cvra/kicad-lib/3Dmodels/Capacitors/CAP0402.step

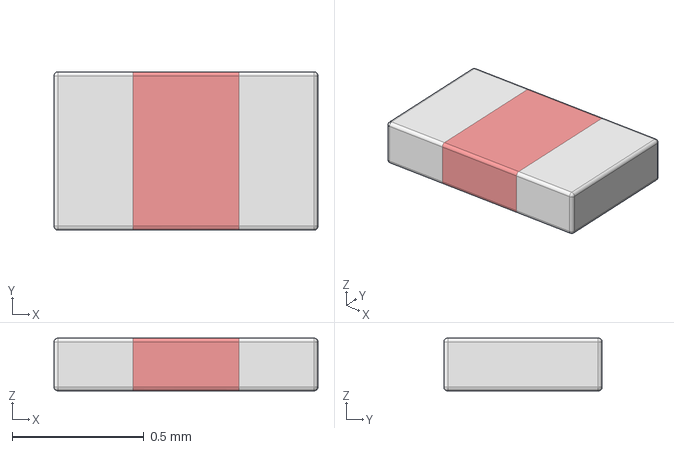
[picture p1: CAD file, 2016-01-29]
3Dmodels/Capacitors/CAP0402.step
1.00 x 0.6 x 0.2 mm
