cvra/kicad-lib/3Dmodels/Diverse/ESP-12.step

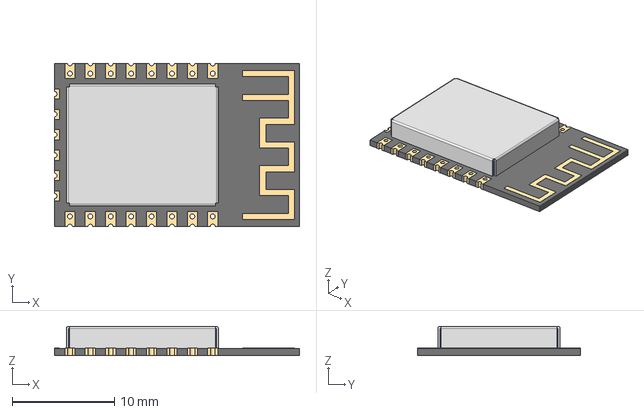
[picture p2: CAD file, 2016-06-26]
3Dmodels/Diverse/ESP-12.step
24.0 x 16.0 x 2.86 mm
