cvra/kicad-lib/3Dmodels/LEDs/0603_right_angle.stp

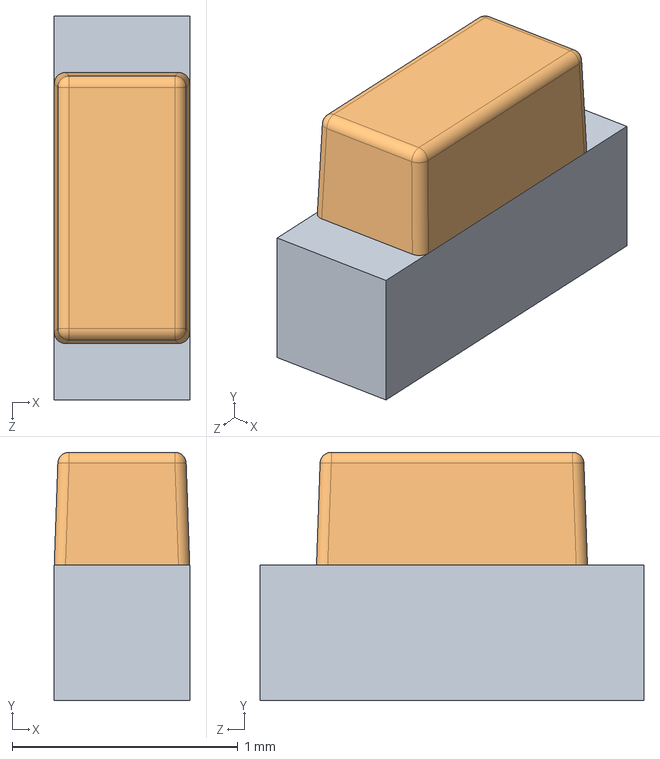
[picture p3: CAD file, 2020-04-17]
3Dmodels/LEDs/0603_right_angle.stp
0.6 x 1.10 x 1.70 mm
