cvra/kicad-lib/3Dmodels/MolexPicoblade/molexpicoblade-horizontal-th-4.step

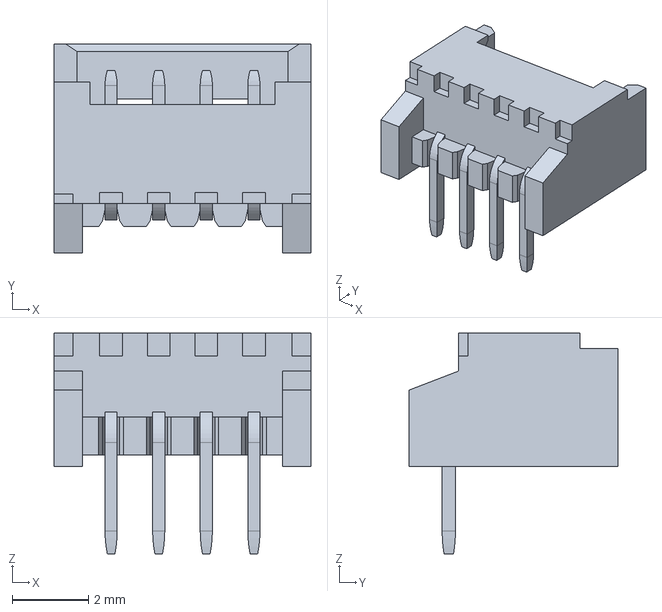
[picture p4: CAD file, 2020-04-10]
3Dmodels/MolexPicoblade/molexpicoblade-horizontal-th-4.step
6.75 x 5.50 x 5.80 mm
