cvra/kicad-lib/3Dmodels/Resistors/RES0603.stp

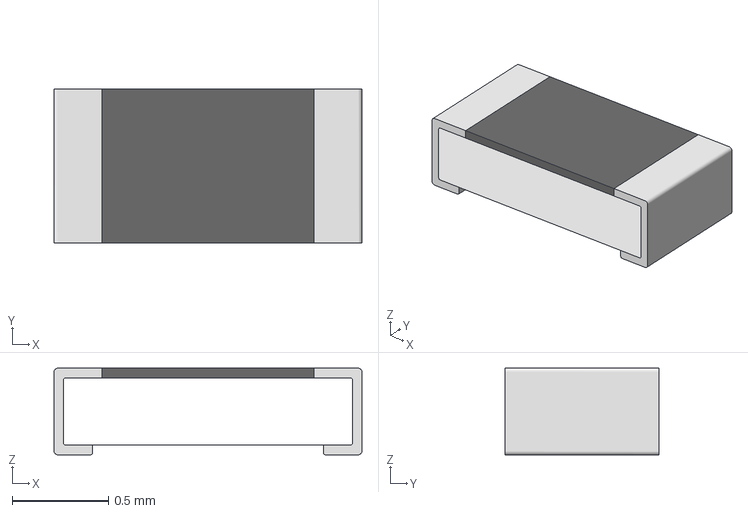
[picture p5: CAD file, 2016-02-28]
3Dmodels/Resistors/RES0603.stp
1.60 x 0.8 x 0.45 mm
