cvra/kicad-lib/3Dmodels/Sensors/MS5611.step

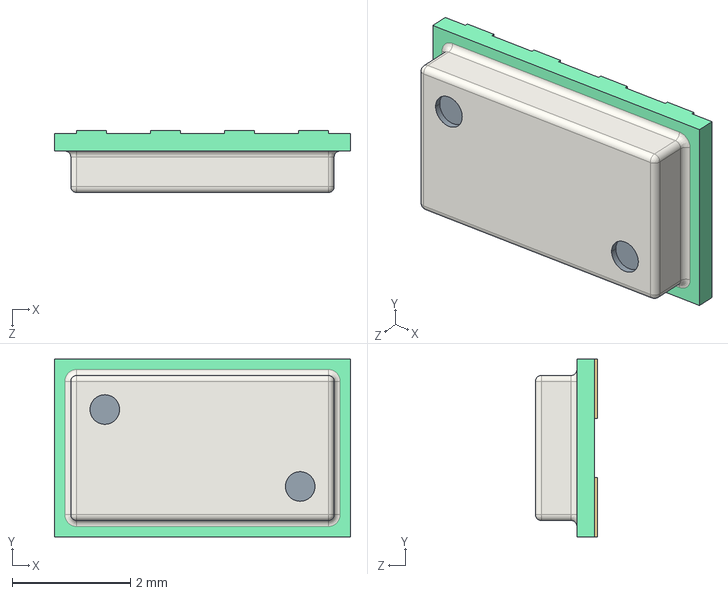
[picture p6: CAD file, 2016-02-28]
3Dmodels/Sensors/MS5611.step
5.00 x 3.00 x 1.05 mm
