cvra/kicad-lib/3Dmodels/SMD/sot363.stp

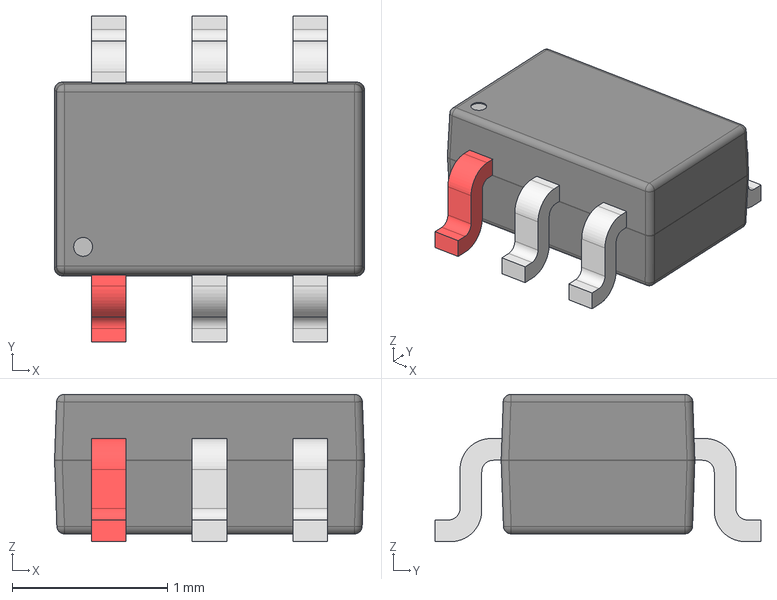
[picture p7: CAD file, 2016-06-04]
3Dmodels/SMD/sot363.stp
2.00 x 2.10 x 0.95 mm
