cvra/kicad-lib/3Dmodels/Switches/CFPA-1FB4-A2T.stp

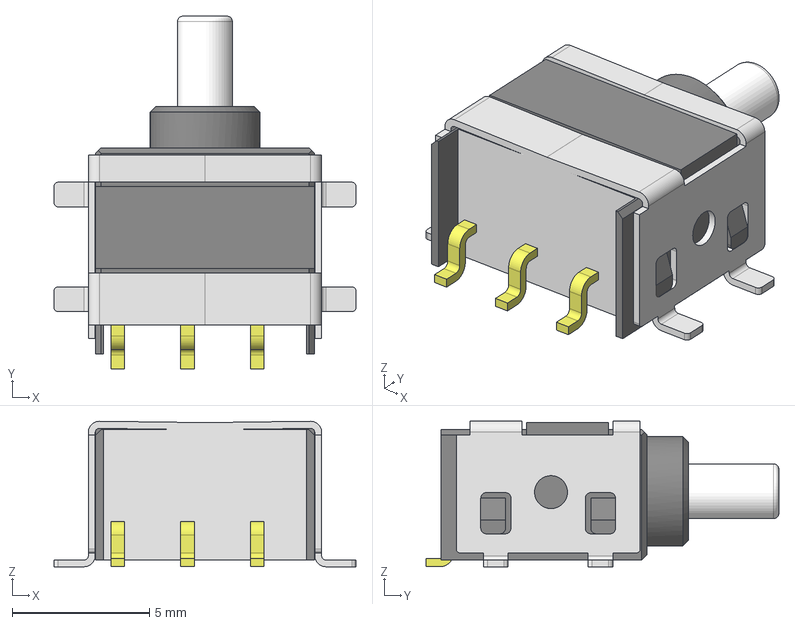
[picture p8: CAD file, 2020-04-10]
3Dmodels/Switches/CFPA-1FB4-A2T.stp
11.0 x 12.9 x 5.30 mm
_CFPA body
_CFPA button
