cvra/kicad-lib/3Dmodels/TSSOP/tssop28.step

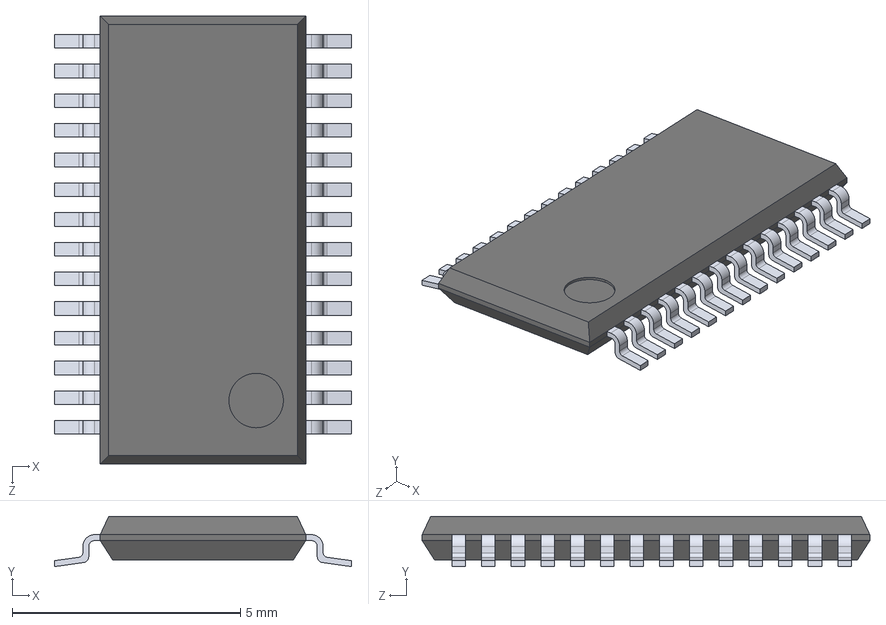
[picture p9: CAD file, 2016-06-04]
3Dmodels/TSSOP/tssop28.step
6.50 x 1.10 x 9.80 mm
