cvra/kicad-lib/3Dmodels/Diverse/Crystal_SMD_ABS07.step

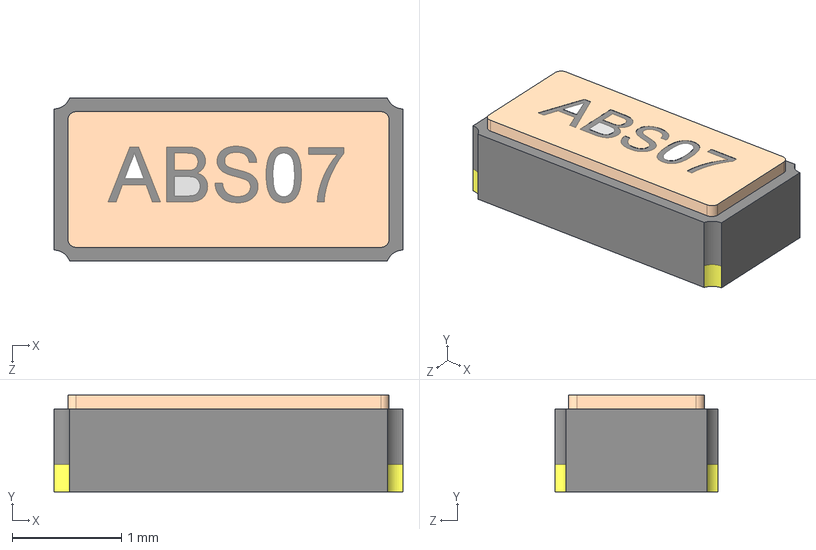
[picture p10: CAD file, 2016-06-04]
3Dmodels/Diverse/Crystal_SMD_ABS07.step
3.20 x 0.889 x 1.50 mm
