cvra/kicad-lib/3Dmodels/LEDs/CRGB1318FSE_rgb_led.stp

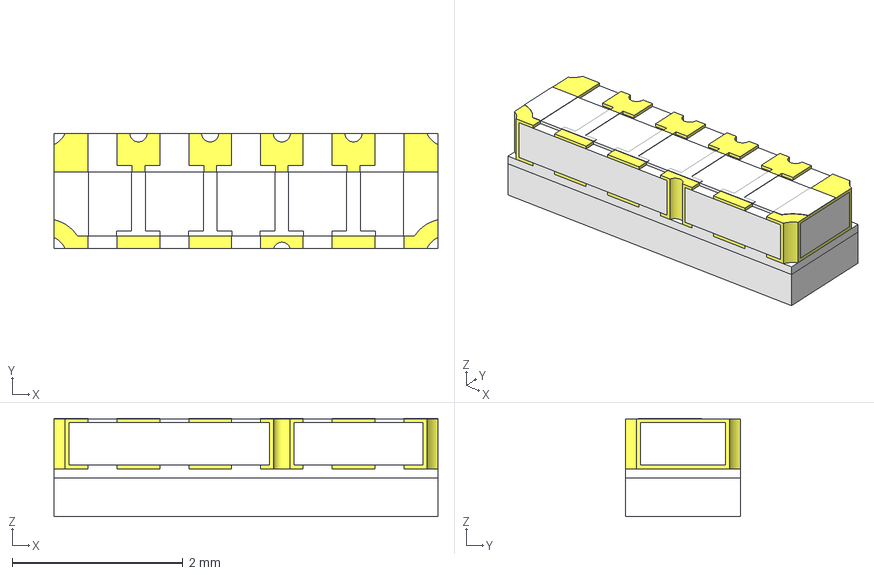
[picture p11: CAD file, 2020-04-10]
3Dmodels/LEDs/CRGB1318FSE_rgb_led.stp
4.50 x 1.35 x 1.15 mm
