cvra/kicad-lib/3Dmodels/MolexPicoblade/molexpicoblade-horizontal-smd-4.step

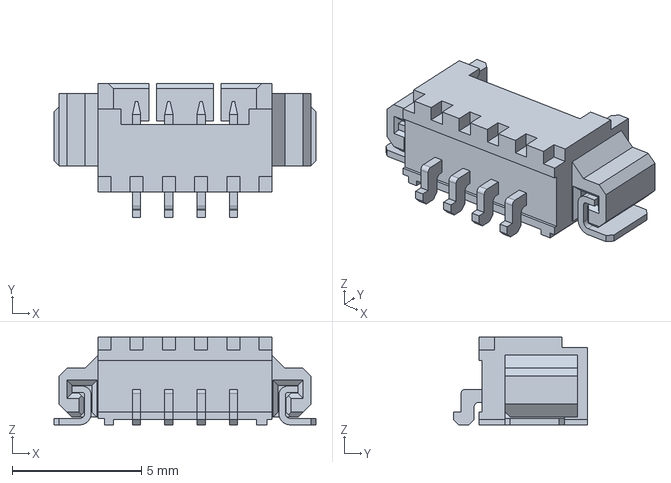
[picture p12: CAD file, 2016-06-28]
3Dmodels/MolexPicoblade/molexpicoblade-horizontal-smd-4.step
10.2 x 5.20 x 3.40 mm
