cvra/kicad-lib/3Dmodels/Resistors/RES0402.step

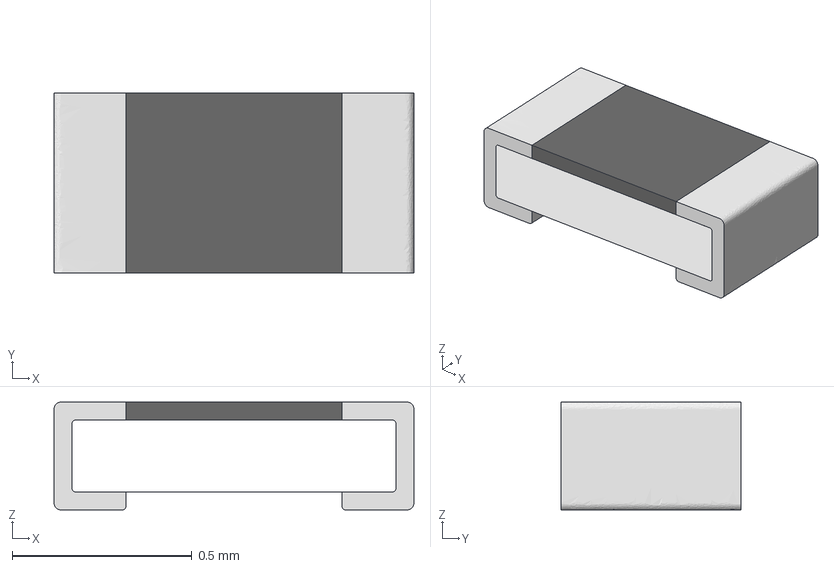
[picture p13: CAD file, 2016-01-29]
3Dmodels/Resistors/RES0402.step
1.00 x 0.5 x 0.3 mm
