cvra/kicad-lib/3Dmodels/Sensors/InvensenseMPU.step

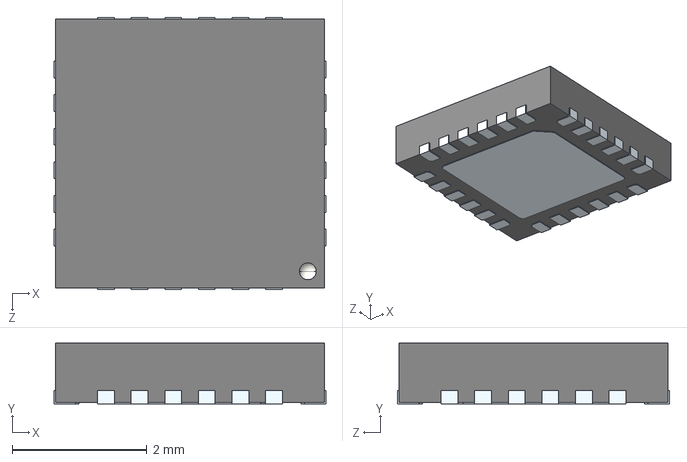
[picture p14: CAD file, 2016-02-28]
3Dmodels/Sensors/InvensenseMPU.step
4.04 x 0.9 x 4.04 mm
