cvra/kicad-lib/3Dmodels/SMD/SC-90.stp

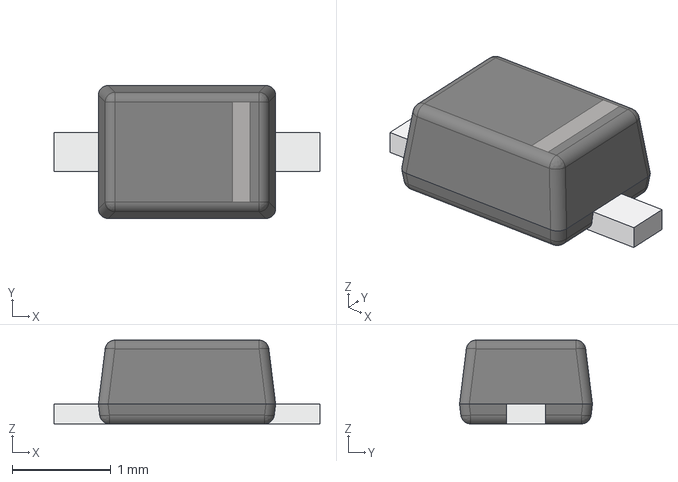
[picture p15: CAD file, 2016-06-04]
3Dmodels/SMD/SC-90.stp
2.70 x 1.35 x 0.85 mm
