cvra/kicad-lib/3Dmodels/Connectors/micro_sd_molex_502570.step

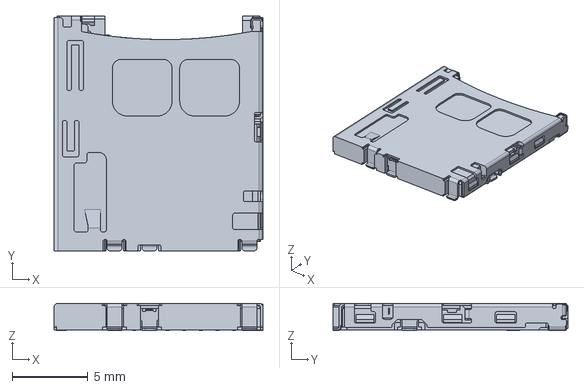
[picture p16: CAD file, 2016-06-26]
3Dmodels/Connectors/micro_sd_molex_502570.step
13.8 x 15.5 x 1.80 mm
