cvra/kicad-lib/3Dmodels/Diverse/Crystal_SMD_ABMM2.step

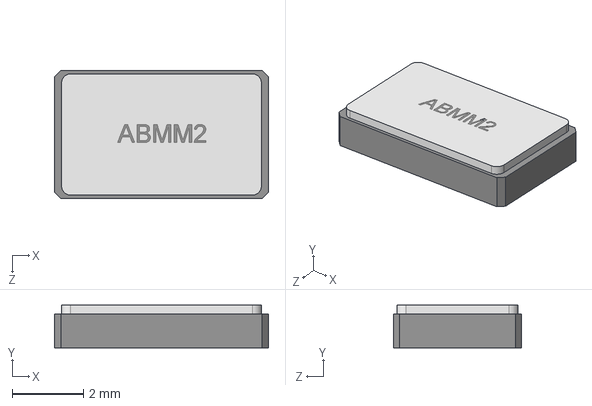
[picture p17: CAD file, 2016-06-04]
3Dmodels/Diverse/Crystal_SMD_ABMM2.step
6.00 x 1.20 x 3.60 mm
