cvra/kicad-lib/3Dmodels/LEDs/0603_led.step

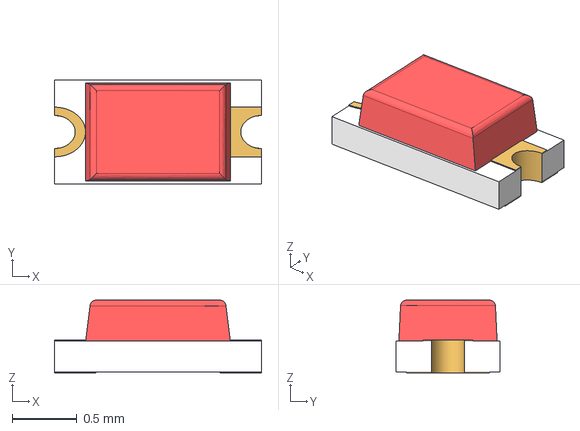
[picture p18: CAD file, 2016-01-29]
3Dmodels/LEDs/0603_led.step
1.60 x 0.8 x 0.563 mm
