cvra/kicad-lib/3Dmodels/Connectors/molex_picoblade_4pin_smd_right.stp

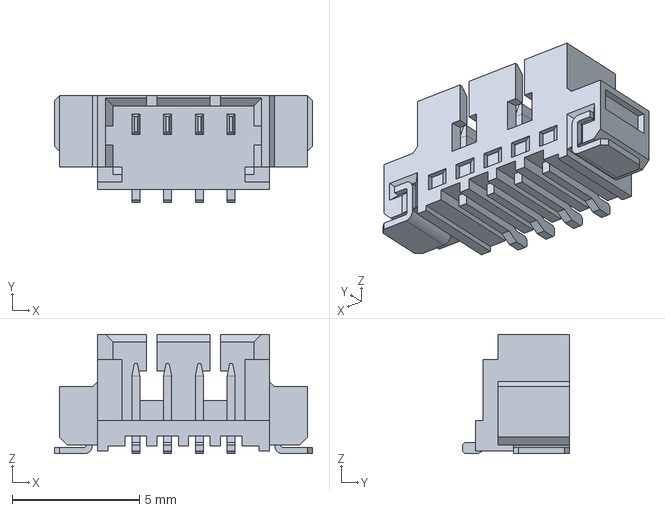
[picture p19: CAD file, 2016-06-04]
3Dmodels/Connectors/molex_picoblade_4pin_smd_right.stp
10.2 x 4.20 x 4.70 mm
