cvra/kicad-lib/3Dmodels/Diverse/PWSON-N12.step

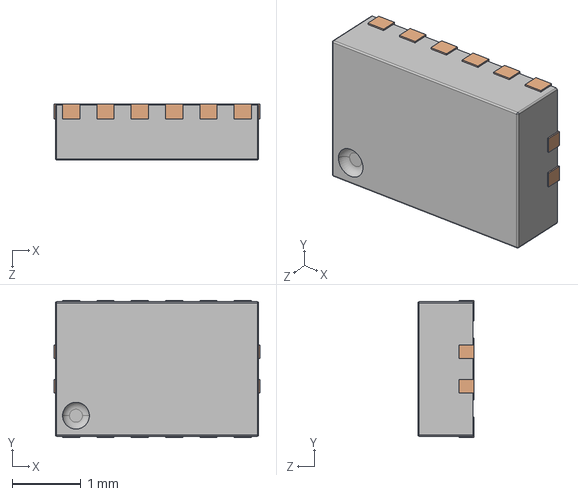
[picture p20: CAD file, 2016-02-28]
3Dmodels/Diverse/PWSON-N12.step
3.00 x 2.00 x 0.82 mm
