cvra/kicad-lib/3Dmodels/Connectors/molex_picoblade_8pin_smd_right.step

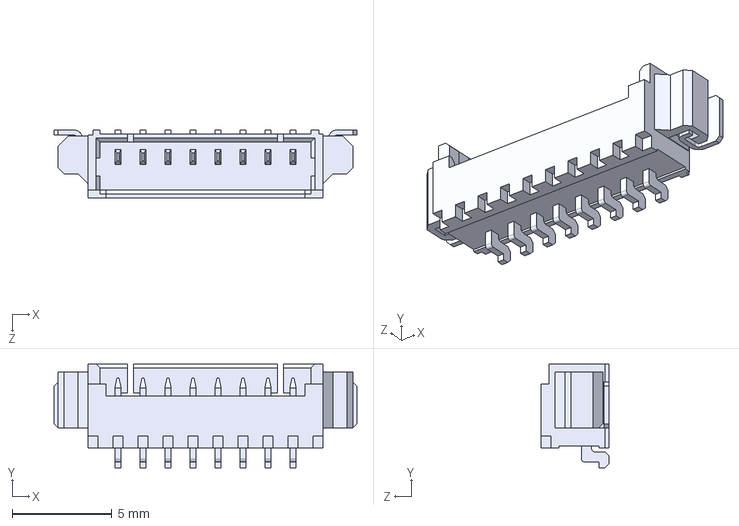
[picture p21: CAD file, 2016-06-04]
3Dmodels/Connectors/molex_picoblade_8pin_smd_right.step
15.2 x 5.20 x 3.40 mm
