cvra/kicad-lib/3Dmodels/Diverse/Crystal_SMD_3225.step

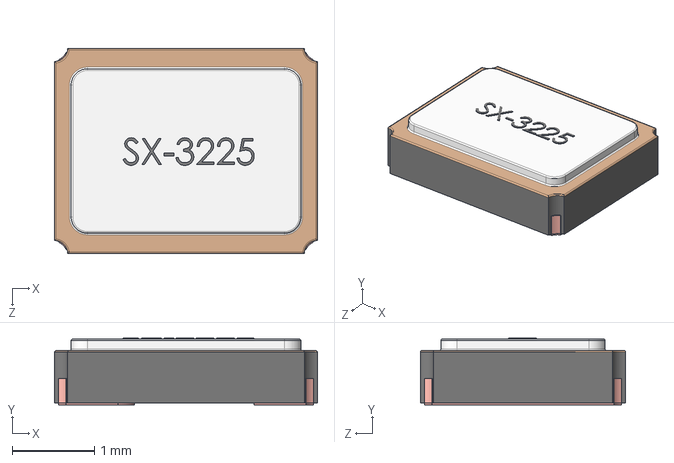
[picture p22: CAD file, 2016-02-28]
3Dmodels/Diverse/Crystal_SMD_3225.step
3.20 x 0.81 x 2.50 mm
