cvra/kicad-lib/3Dmodels/Connectors/pin_angled1x3.step

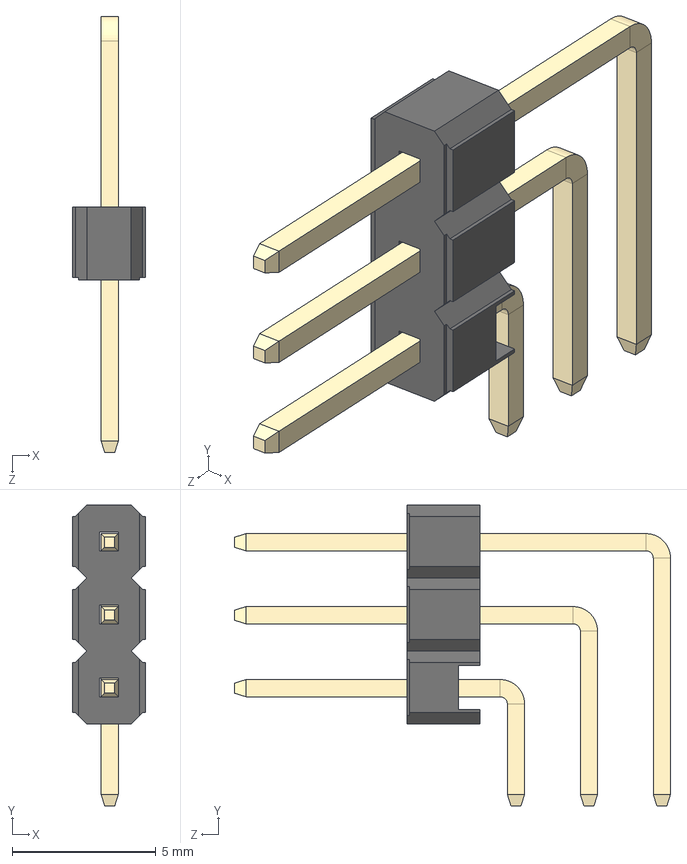
[picture p23: CAD file, 2016-06-04]
3Dmodels/Connectors/pin_angled1x3.step
2.54 x 10.5 x 15.2 mm
2.54_base
2.54_angle-pin
2.54_angle-pin_level 2
2.54_angle-pin_level 3
