cvra/kicad-lib/3Dmodels/Diverse/QFN-20 5x5x0_9mm.step

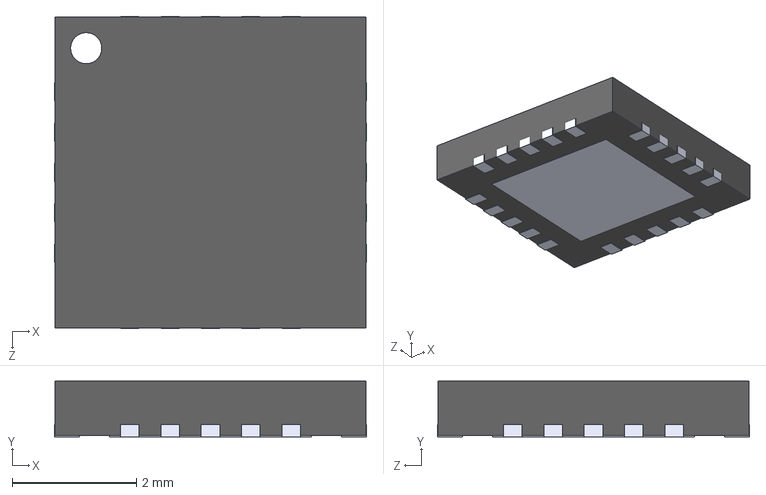
[picture p24: CAD file, 2016-02-28]
3Dmodels/Diverse/QFN-20 5x5x0_9mm.step
5.02 x 0.9 x 5.02 mm
