cvra/kicad-lib/3Dmodels/Connectors/micro_sd_molex_wm6701.step

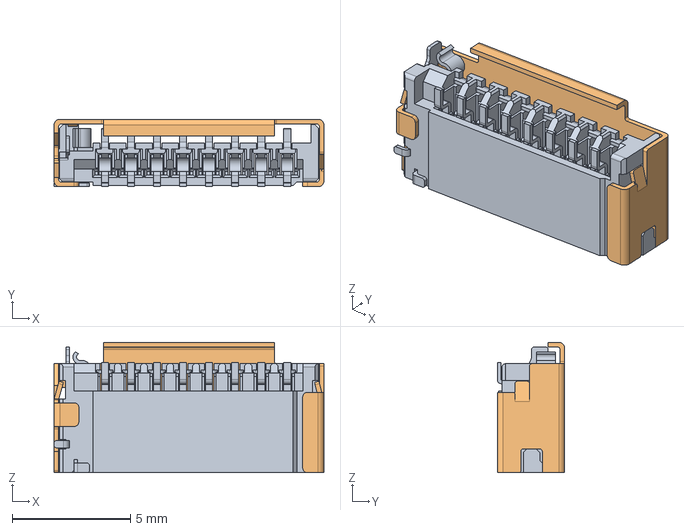
[picture p25: CAD file, 2016-01-29]
3Dmodels/Connectors/micro_sd_molex_wm6701.step
11.4 x 2.85 x 5.50 mm
