cvra/kicad-lib/3Dmodels/Diverse/TSOT23-5.step

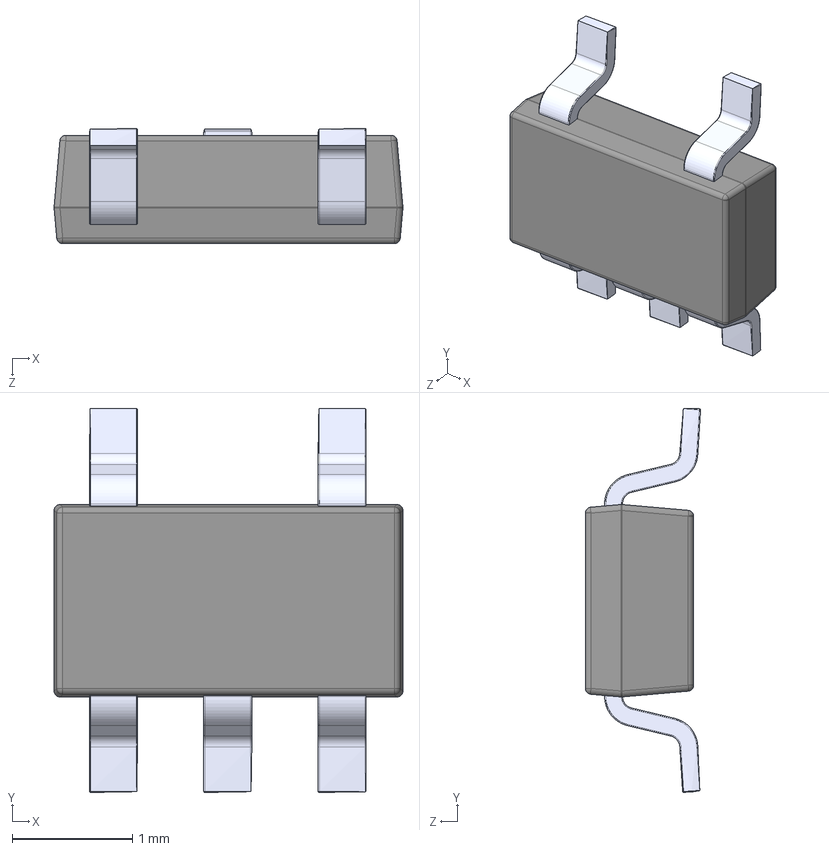
[picture p26: CAD file, 2016-02-28]
3Dmodels/Diverse/TSOT23-5.step
2.90 x 3.19 x 0.957 mm
SW3dPS-TSOT23-5_TSOT23-5-pinout_?? ?????????
SW3dPS-TSOT23-5_TSOT23-5-case_?? ?????????
