cvra/kicad-lib/3Dmodels/Connectors/micro_usb_fci_10118193.step

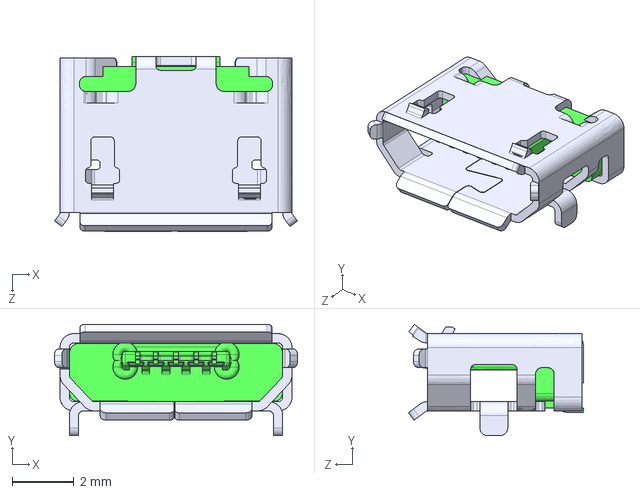
[picture p27: CAD file, 2016-01-29]
3Dmodels/Connectors/micro_usb_fci_10118193.step
7.86 x 3.60 x 5.66 mm
