cvra/kicad-lib/3Dmodels/Diverse/AntennaChipSMD.step

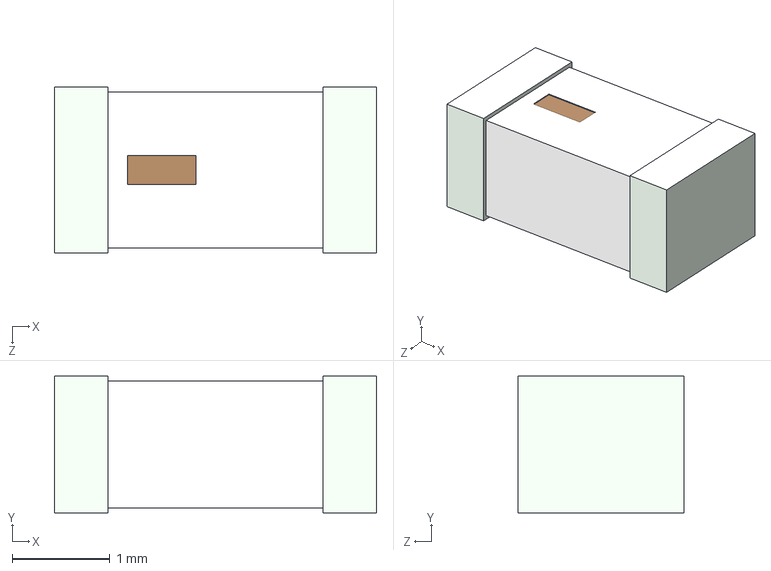
[picture p28: CAD file, 2016-02-28]
3Dmodels/Diverse/AntennaChipSMD.step
3.30 x 1.40 x 1.70 mm
