cvra/kicad-lib/3Dmodels/Diverse/DFN-8.step

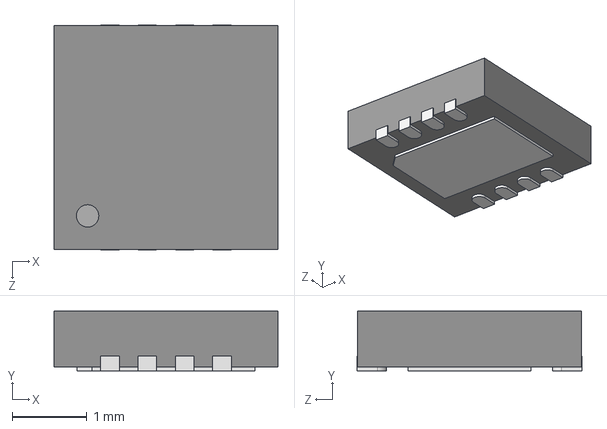
[picture p29: CAD file, 2016-02-28]
3Dmodels/Diverse/DFN-8.step
3.00 x 0.8 x 3.02 mm
