cvra/kicad-lib/3Dmodels/Diverse/SOD323.step

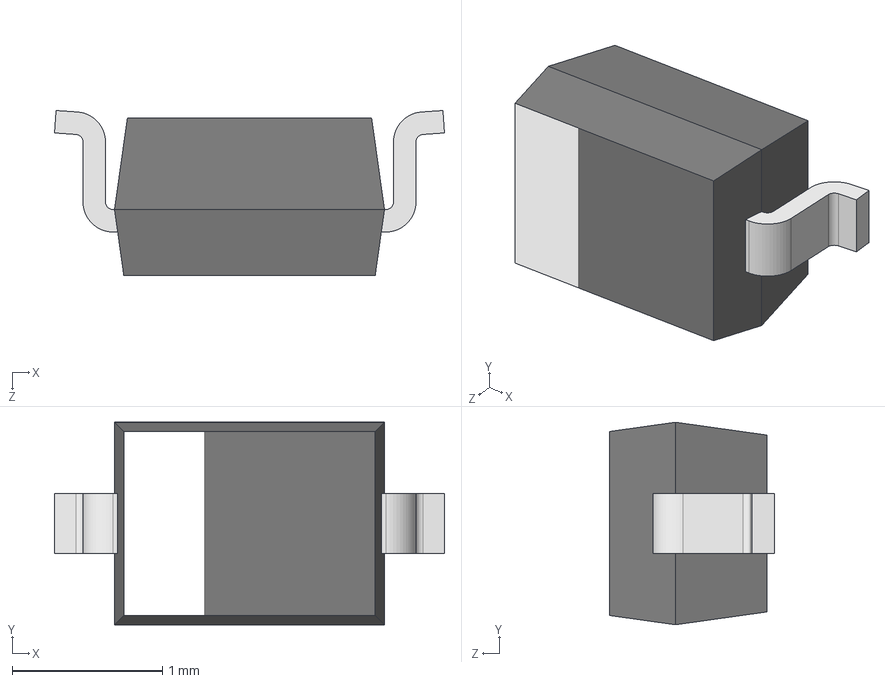
[picture p30: CAD file, 2016-02-28]
3Dmodels/Diverse/SOD323.step
2.60 x 1.35 x 1.10 mm
