cvra/kicad-lib/3Dmodels/Diverse/SOT23.step

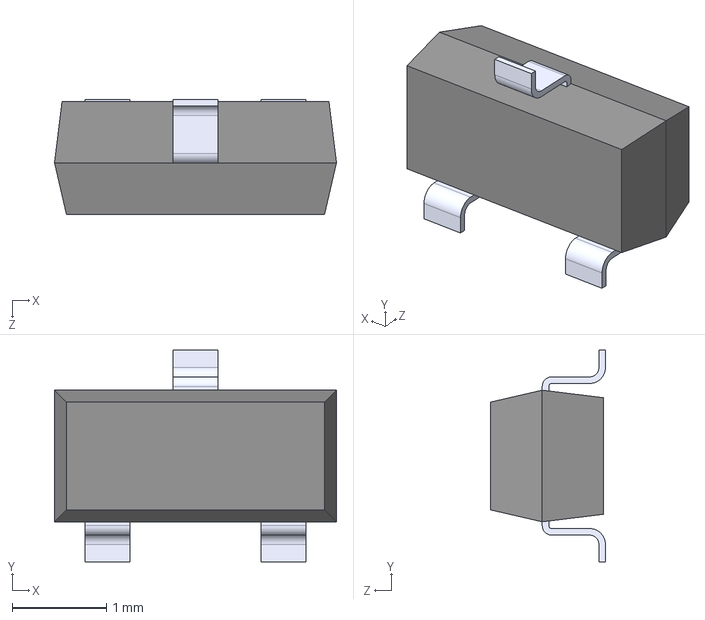
[picture p31: CAD file, 2016-01-29]
3Dmodels/Diverse/SOT23.step
3.00 x 2.25 x 1.22 mm
