cvra/kicad-lib/3Dmodels/Diverse/B3U_3000P.step

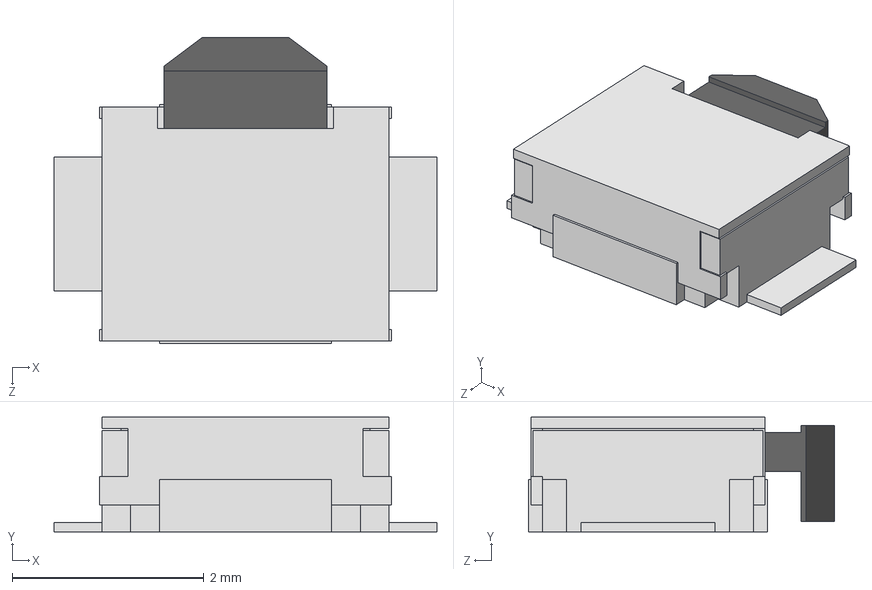
[picture p32: CAD file, 2016-01-29]
3Dmodels/Diverse/B3U_3000P.step
4.00 x 1.20 x 3.20 mm
