cvra/kicad-lib/(list of files, cad)

Other CAD files:
3Dmodels/Connectors/615108150221R_Ethernet_MiddleMount.stp
3Dmodels/Connectors/878330821.stp
