cvra/kicad-lib/(threads)

Thread 2 (2016-11-09):

Ublox MAX M8 model does not line up with pcb

jskorepa, 2016-11-09:
What am I doing wrong?
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

nuft, 2016-11-10:
I think it's a problem of metric vs imperial units used in the 3D model and in KiCad's 3D viewer.

At the moment I don't know if the model is wrong or if the 3D viewer doesn't distinguish between units.

A workaround would be to set a scale factor to convert the units. You can set the scale factor under "3D settings" in the "Footprint Properties" of the ublox footprint.
Try something like 0.254 (imperial-> metric) or 0.393701 (metric -> imperial).

jskorepa, 2016-11-10:
Thank you for your fast response. It is indeed the case. Now it has wrong offset, i can guess it, but do you know a way to calculate it?
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

nuft, 2016-11-10:
Probably the origins aren't the same.

Open the footprint in the editor to find the offset of the origin. The 3D model's origin is probably right in the center.

Closed 2016-11-10.
