cvra/kicad-lib/(commit log)

2014-02-03 added STM32F303CCT6 symbol
2014-02-03 added nRF24L01+ and antenna symbols
2014-02-03 added sensor footprint library
2014-02-03 added LQFP48 and LQFP64 footprints
2014-02-03 added connectors footprint library
    including Molex PicoBlade SMD: 4,6,8 Pin variants
2014-02-03 added micro USB AB SMT receptacle footprint
2014-02-03 added standard packages footprint library
    added SO-8 and SOT23-8 footprints
2014-02-03 added 6 pin TSOT23 footprint
2014-02-04 added 5 pin TSOT23 and 8 pin TSSOP footprints
2014-02-04 added MSOP-8 footprint
2014-02-04 added MPU-60X0 footprints
2014-02-04 added H3LIS331DL accelerometer footprint
2014-02-07 added Crystal symbol and footprint
2014-02-07 added 2 Pin Molex PicoBlade and MSOP-8 wich exposed pad footprints
2014-02-07 renaming rest of footprint library
2014-02-07 renamed SMD crystal footprint
2014-02-09 added 0603 footprints
2014-02-09 added 3- and 6-pin Fairchild SuperSOT MOSFET footprints
2014-02-13 add mechanical library
    - M2 mounting hole
2014-02-15 updated 0603 footprint
    moved center in between pads
2014-02-15 added Molex microSD 502570-0893 footprint
    without silkscreen outline
2014-02-15 added outline of Molex microSD 502570-0893 footprint
    changed Value and Reference text size and position
2014-02-15 changed reference and value text size and position of all footprints
2014-02-15 remove MPU60X0 ground pad
2014-02-15 updated sd card connector
2014-02-16 modified sd connector symbol to match footprint
2014-02-24 added 2.54mm solder pad connector (2pin)
2014-02-25 molex connectors connect mechanical pads to GND
2014-02-26 add SC79 (diode) footprint
2014-03-04 added a footprint for QFN20 with exposed pad
2014-03-05 added ANT-2.45-CHP 2.4GHz chip antenna footprint
    ANT-2.45-CHP from Antenna Factor
2014-03-05 added STM32F030C8T6 component
2014-03-08 more 2.54mm solder pads + 2mm pin
2014-03-08 added zig-zag version of 2mm pin
2014-03-08 add swd connector
2014-03-10 make pin header pin1 rectangular
2014-03-10 2mm zig-zag pin header: change offset from 0.15mm to 0.2mm
2014-03-13 added MCP1703 component and footprint
2014-03-27 add STM32F373CCT6
2014-04-19 add 1.27mm smd solder pads
2014-05-13 new lib charge-pump-regulators
    add LTC3200-5
2014-11-09 LED RGB Modifie
2014-11-13 add cvra footprint library
2014-11-15 Jumper + LedRGB
2014-11-16 Add CVRA-PWSON-N6 and PSONL10 footprint in cvra lib
2014-11-26 can_connector footprint
2014-11-27 add ribbon cable connector
2014-11-28 add ribbon cable connector 7pin
2014-12-06 Can connector all pads round
2014-12-06 Power connector
2014-12-06 2mm zig-zag pin header: change offset from 0.2mm to 0.3mm
2014-12-07 Move footprint libraries to new .pretty lib format.
2014-12-07 Add PTS525 SMD Pushbutton footprint.
2014-12-07 Add SOD-323 footprint.
2014-12-08 change connector drill to standard size
2014-12-09 Add MCP1700 SOT-89 footprint.
2014-12-09 footprint: Micro USB AB, fix clearance values, make shield pad numbers the same.
2014-12-09 footprint: 8 pin SOT23 fix clearance.
2015-02-02 Add MCP73831 linear regulator for Lithium USB recharge
2015-02-05 Add footprints for TO-263 D2Pak, S8, Power resistor SM3
2015-03-22 Add some IC/sensors
    XBee Header
    EEPROM
    LPS331
    MPU 9150
    GPS MTK339
    Connector 2x23 (Half BBB header)
    SMA Connector
2015-03-28 Add LPS331AP (pressure sensor)
2015-03-28 Add Molex WM6701 microSD connector footprint
2015-03-28 fix sd-card connector gnd pad
2015-03-30 Add component MT9V034 (Aptina camera sensor)
2015-04-21 Add STM32f407IE (176 pin BGA) symbol
2015-04-21 Add TOF sensor: VL6180X symbol
2015-04-22 CAN connector rename CAN+/- to CANH/L
2015-04-25 TI DRV8839 motor driver symbol
2015-05-01 Add pushbutton power handler LTC2955DDB-1
2015-05-02 Modify INA21x current shunt amplifier
2015-05-24 FIX: correct Molex footprint pin enumeration.
2015-05-24 Add STM32F105RBT6 symbol.
2015-05-29 Add SOT223 footprint
2015-06-16 Add STM32F042 in TSSOP20 package in library
2015-06-27 Add time of flight sensor VL6180X footprint
2015-06-30 Add STM32F302C8T component.
2015-07-16 Add LED PWM generator PCA9685
2015-07-18 Component: TI BuckBoost TPS63060
2015-07-20 Add GPS ublox MAX M8 & Load Switch TI TPS22929D
2015-07-20 Connectors: SPI, ADC
2015-07-20 Add TPS22986 + Footprints PWSON12, WSON10, Testpad SMD
2015-07-20 Footprints: inductors, connectors (SMA, coin cell bat, xbee)
2015-07-20 Footprint: GPS ublox MAX M8
2015-07-20 Footprint: Xbee header SMD
2015-07-21 Footprint: Beaglebone cape without battery connectors
2015-07-22 Footprints: Fixing ADC connector & Beaglebone cape
2015-07-23 3D models: Picoblade & SMA connectors
2015-07-23 3D models: 0603 LEDs
2015-07-23 3D models: SMD button, XBeee header / model, Coin cell battery holder
2015-07-23 Footprint: Correct SON 10 footprint used on TI regulators
2015-07-23 Add GND pad to PCA9685 & MPU9250
2015-08-19 Add SiP32431 Slew Rate Controlled Load Switch
2015-10-19 Add MolexPicoblade receptacle through hole footprint
2015-10-19 Add micro USB AB through hole receptacle
2015-10-19 Add small SMD push button footprint
2015-10-20 Add outline to MolexPicoblade footprints.
2015-10-23 Add micro USB AB through hole without slot
2015-10-24 Add SOT-23 footprint with larger pads.
2015-10-25 Micro USB footprints: remove local clearance, add solder paste layer.
2015-10-26 Micro USB no slot: remove silkscreen from pad, increase drill diameter
2016-01-20 Add 2pin ADC connector
2016-01-28 Add footprint for small SMD testpad
2016-01-28 Add LED footprint
2016-01-29 Add 3d models for some footprints
    - 0402 capacitors & resistors
    - B3U push button
    - Micro SD molex WM6701
    - Micro USB
    - SOT23
    - LQFP 64
    - Picoblade 8 pins
    [0603_led.step, B3U_3000P.step, CAP0402.step, RES0402.step, SOT23.step, micro_sd_molex_wm6701.step, micro_usb_fci_10118193.step]
2016-02-01 Add MCP251 CAN over SPI chip
2016-02-05 Add ADC 3 pin connector
2016-02-08 Add digital input connector with power pin
2016-02-08 Add digital output connector
2016-02-12 Add connector for RGB LED
2016-02-12 Add connector for a load
2016-02-20 Remove mechanical ground connections
2016-02-20 add swd + uard debug connector symbol
2016-02-20 add LTC4415 ideal diode controller
2016-02-20 add LTC3118, 18V, 2A Buck-Boost DC/DC
2016-02-23 LTC4415 fix missing GND, rearrange pins
2016-02-27 Add some footprints
    - DFN 8 lead 2x3mm
    - Battery ML621 Panasonic
    - Crystal ABMM2
    - Crystal ABS07
    - Diode SMini2
    - SOT363
2016-02-28 Add MPU9xx0 footprint
2016-02-28 Add more 3D models
    [AntennaChipSMD.step, Crystal_SMD_3225.step, DFN-8.step, InvensenseMPU.step, MS5611.step, PWSON-N12.step, QFN-20 5x5x0_9mm.step, RES0603.stp]
2016-02-28 Add more 3d models to footprints
    [Crystal_SMD_ABMM2.step, Crystal_SMD_ABS07.step, SC-90.stp, molex_picoblade_4pin_smd_right.stp, molex_picoblade_8pin_smd_right.step, pin_angled1x3.step, sot363.stp, tssop28.step]
2016-03-01 dual N-fet NTJD4001N
2016-03-01 add STM32F302K8U6 (QFN32)
2016-05-31 Add time of flight sensor VL53L0X symbol
2016-06-04 Add new ST TOF sensor VL53L0X footprint
2016-06-23 Fix STM32F405 pin name
2016-06-26 Add testpad footprint
2016-06-26 Add ESP12E footprint
2016-06-26 Add Molex uSD card 3D model
    [micro_sd_molex_502570.step]
2016-06-26 Add ESP12 3D model
    [ESP-12.step]
2016-06-26 Update testpad footprint
2016-06-28 Add DWM1000 3D model
    [DWM1000.step]
2016-06-28 Fix DWM1000 3D model
    [DWM1000.step]
2016-06-28 Add Molex picoblade 4pin SMD horizontal 3D model
    [molexpicoblade-horizontal-smd-4.step]
2016-06-28 Fix M2 hole cotations
2016-06-28 Add 1pin testpad footprint
2016-07-13 Update MPU9250 to new footprint QFN24 3x3mm 0.4mm pitch
2016-07-17 Add STM32F042K6T6
2016-07-20 Fix DWM1000 footprint
2016-07-20 Fix MPU9xx0 silkscreen
2016-07-20 Add standard discrete SMD footprints
    Copied from Kicad standard libraries but with fixed silkscreen
2016-07-24 Add VL53L0X TOF distance sensor footprint
2016-07-24 Remove SOT-23 footprint with wrong pin number
2016-08-31 Add ST-VL53L0X 3D model, adjust silkscreen outline
2016-08-31 Add GND pad to LTC2875 symbol
2016-08-31 STM32F302K8U6 QFN missing GND pad
2016-09-06 Add ST-VL53L0X adjust silkscreen outline
2017-02-27 change ST_Nucleo144_F429ZI_Morpho pin numbering
2017-02-27 Add ST_Nucleo144_F429ZI_Morpho footprint
2017-03-04 ST_Nucleo144_F429ZI_Morpho pin numbering yet again
2017-04-28 Create a README
    Contains the same license as the motor board repo
2017-05-04 Remove silkscreen over pads
2017-05-07 Use recommended soldermask and paste layout
    See TI's SLOA122 QFN Layout Guidelines
2017-07-03 Longer pads for QFN48 to ensure proper soldering
    As suggested in Linear's user guide for QFN
2017-07-03 Remove solderpaste grid
    It causes DRC error, which sucks
2018-01-04 fix pin types of ADP150-2.8
2020-01-18 Draw DRV8847 schematic drawing for TSSOP package
2020-01-18 Draw MPRLS0015PA000 schematic drawing
2020-02-06 Update DRV8847 motor driver symbol according to KiCAD convention
2020-02-06 Update MPR pressure sensor symbol according to KiCAD convention
2020-02-08 Add MPR pressure sensor footprint
2020-02-12 Active low style in MPR sensor and DRV8847 motor driver
2020-02-16 Updated MPR pressure sensor footprint, specify type
2020-02-23 Add HTSSOP version of DRV8847 motor driver symbol
2020-03-19 Add component for CRGB1318FSE RGB LED
2020-04-10 Add components used in front panel board
    [615108150221R_Ethernet_MiddleMount.stp, 878330821.stp, CFPA-1FB4-A2T.stp, CRGB1318FSE_rgb_led.stp, molexpicoblade-horizontal-th-4.step]
2020-04-17 Add horizontal led footprint & 3d
    [0603_right_angle.stp]
2020-04-17 Have silkscreen tighter to the connector
